object1037/dash/README.md

# Dash

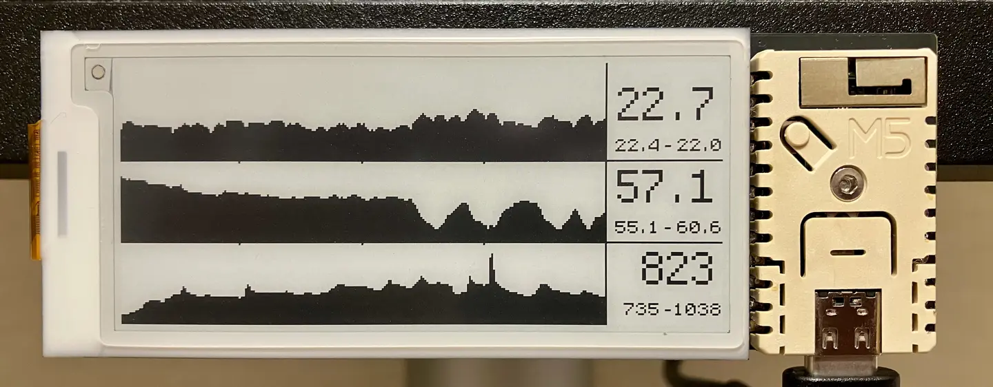
[picture p1: dash.webp]
Dash image


Environment monitor (Temperature, Relative humidity, CO2) with e-paper display.

Inspired by [pico-env-mon](https://github.com/shapoco/pico-env-mon).
