object1037/dash/hardware/dash.pdf

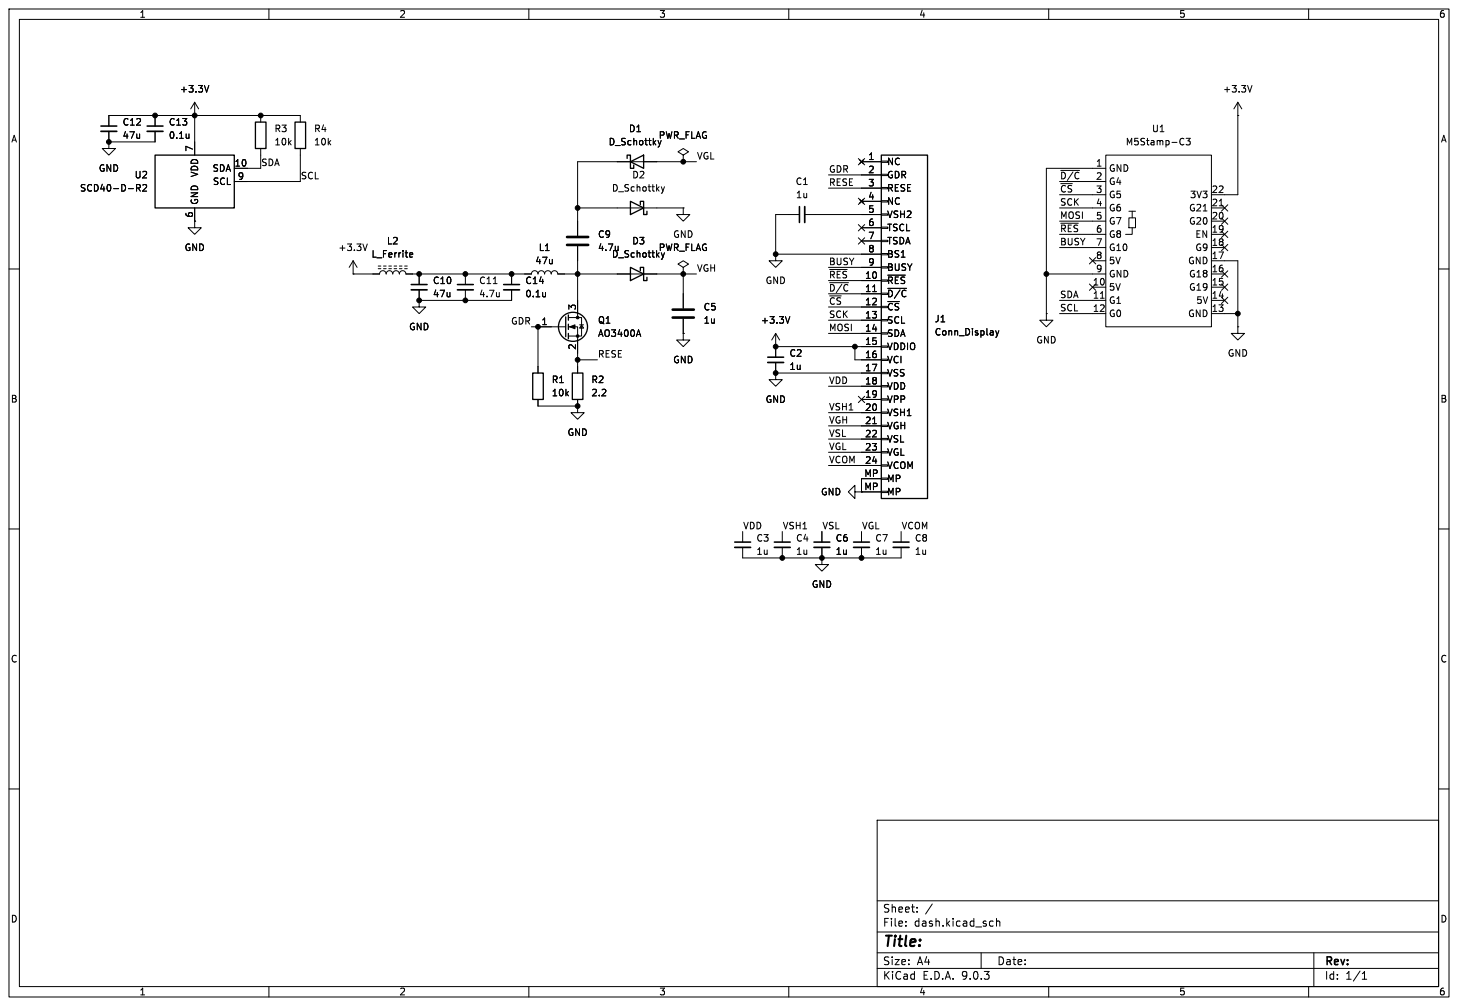
[picture p2: page 1]

6 SDA 10 SCL U2 9 SCD40-D-R2 NC 1 GDR 2 RESE 3 NC 4 VSH2 5 TSCL 6 TSDA 7 BS1 8 BUSY 9 ~{RES} 10 ~{D/C} 11 ~{CS} 12 SCL 13 SDA 14 VDDIO 15 VCI 16 VSS 17 VDD 18 VPP 19 VSH1 20 VGH 21 VSL 22 VGL 23 VCOM 24 MP MP MP MP

6 SDA 10 SCL 9 GND GND GNDGND

Id: 1/1 Title: File: dash.kicad_sch Sheet: /
