object1037/dash/hardware/dash.kicad_pcb

## KiCad design hardware/dash.kicad_pcb (2025-08-30)

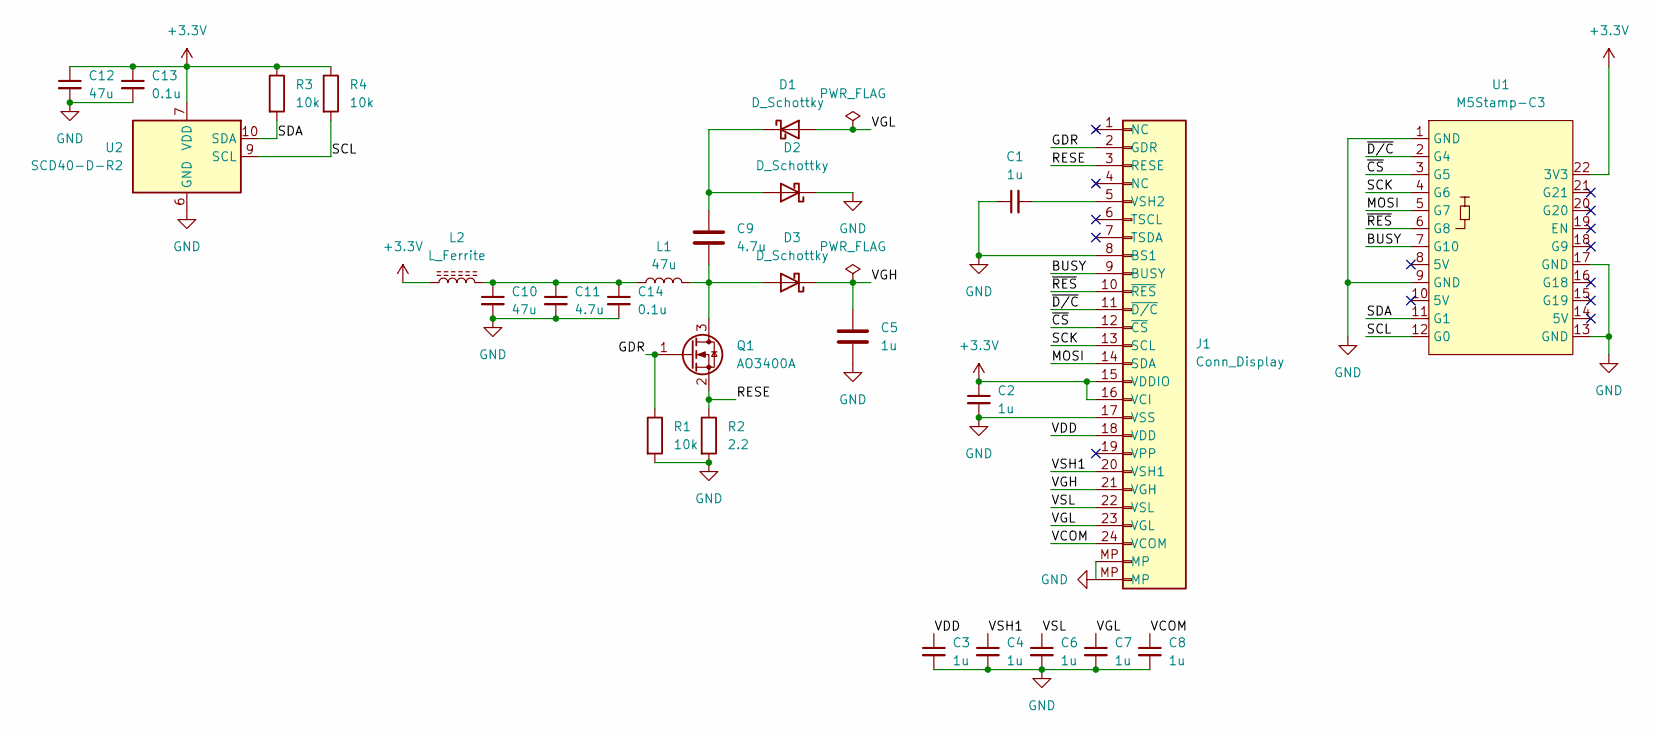
[picture p3: schematic dash.kicad_sch]

Parts:
C1, C2, C3, C4, C5, C6, C7, C8: 1u; C_0603_1608Metric_Pad1.08x0.95mm_HandSolder
C9, C11: 4.7u; C_0805_2012Metric_Pad1.18x1.45mm_HandSolder
C10, C12: 47u; C_0805_2012Metric_Pad1.18x1.45mm_HandSolder
C13, C14: 0.1u; C_0603_1608Metric_Pad1.08x0.95mm_HandSolder
D1, D2, D3: D_Schottky; D_SMA
J1: Conn_Display; Jushuo_AFC07-S24FCA-00_1x24-1MP_P0.50_Horizontal
L1: 47u; L_10.4x10.4_H4.8
L2: L_Ferrite; L_0603_1608Metric_Pad1.05x0.95mm_HandSolder
Q1: AO3400A; SOT-23_Handsoldering
R1, R3, R4: 10k; R_0603_1608Metric_Pad0.98x0.95mm_HandSolder
R2: 2.2; R_0603_1608Metric_Pad0.98x0.95mm_HandSolder
U1: M5Stamp-C3; M5Stamp_C3
U2: SCD40-D-R2; Sensirion_SCD4x-1EP_10.1x10.1mm_P1.25mm_EP4.8x4.8mm

Connections:
+3.3V: C2.1, C12.1, C13.1, J1.15 (VDDIO), J1.16 (VCI), L2.1, R3.1, R4.1, U1.22 (3V3), U2.7 (VDD), U2.19 (VDD)
/BUSY: J1.9 (BUSY), U1.7 (G10)
/GDR: J1.2 (GDR), Q1.1 (G), R1.1
/MOSI: J1.14 (SDA), U1.5 (G7)
/RESE: J1.3 (RESE), Q1.2 (S), R2.1
/SCK: J1.13 (SCL), U1.4 (G6)
/SCL: R4.2, U1.12 (G0), U2.9 (SCL)
/SDA: R3.2, U1.11 (G1), U2.10 (SDA)
/VCOM: C8.1, J1.24 (VCOM)
/VDD: C3.1, J1.18 (VDD)
/VGH: C5.1, D3.1 (K), J1.21 (VGH)
/VGL: C7.1, D1.2 (A), J1.23 (VGL)
/VSH1: C4.1, J1.20 (VSH1)
/VSL: C6.1, J1.22 (VSL)
/~CS: J1.12 (~CS), U1.3 (G5)
/~D/C: J1.11 (~D/C), U1.2 (G4)
/~RES: J1.10 (~RES), U1.6 (G8)
GND: C1.1, C2.2, C3.2, C4.2, C5.2, C6.2, C7.2, C8.2, C10.2, C11.2, C12.2, C13.2, C14.2, D2.1 (K), J1.8 (BS1), J1.17 (VSS), J1.MP, R1.2, R2.2, U1.1 (GND), U1.9 (GND), U1.13 (GND), U1.17 (GND), U2.6 (GND), U2.20 (GND), U2.21 (GND)
unnamed: C10.1, C11.1, C14.1, L1.1, L2.2
unnamed: C9.1, D1.1 (K), D2.2 (A)
unnamed: C9.2, D3.2 (A), L1.2, Q1.3 (D)
unnamed: C1.2, J1.5 (VSH2)

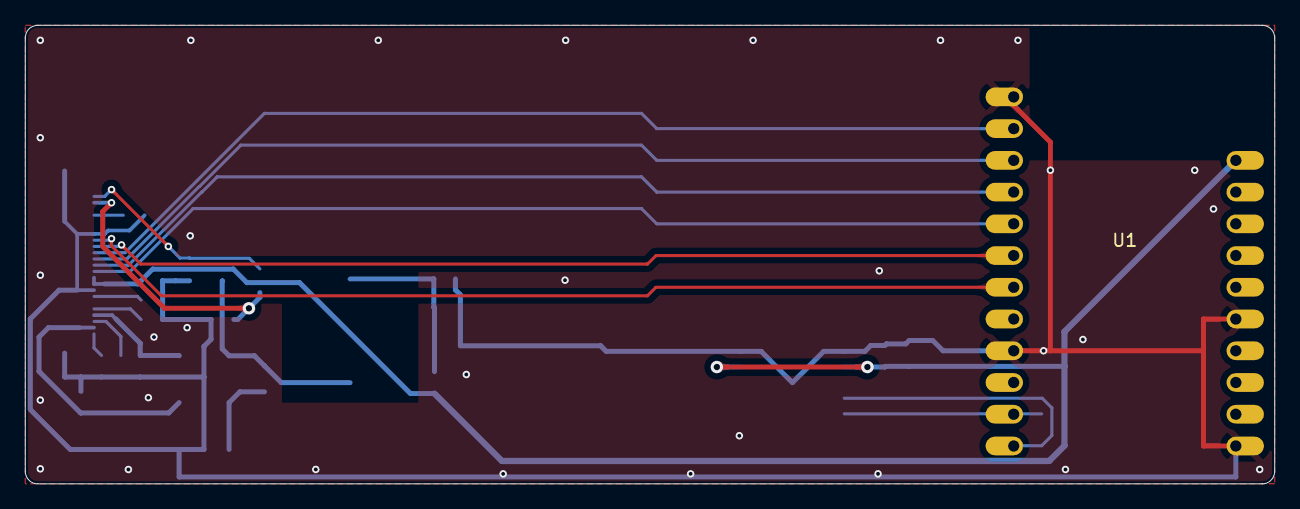
[picture p4: board dash.kicad_pcb from above]

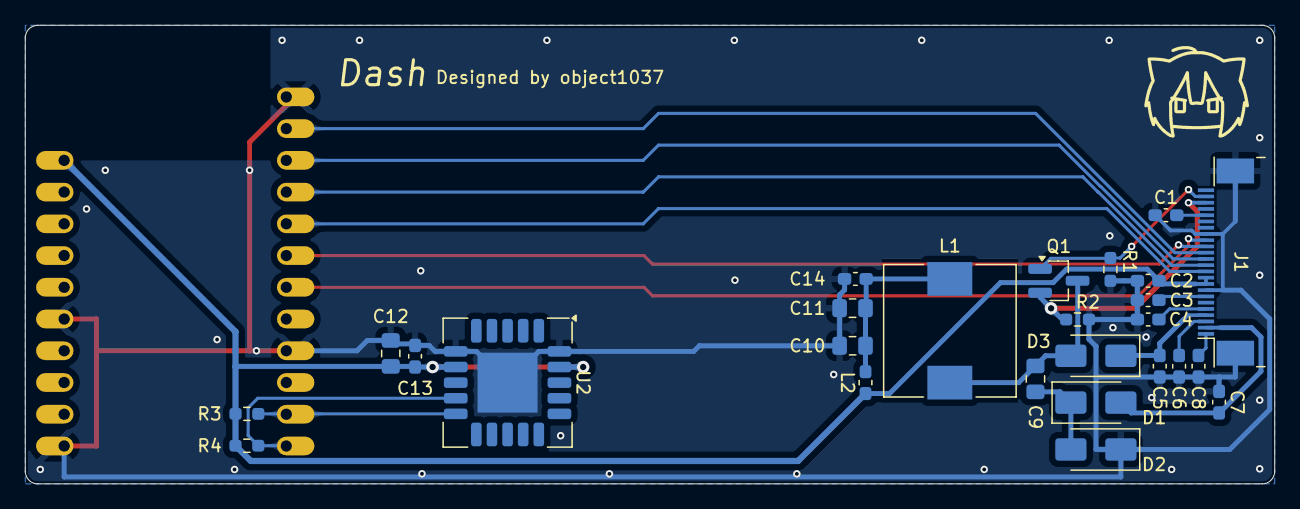
[picture p5: board dash.kicad_pcb from below]

Board: 2 copper layers, 100.0 x 36.7 mm, 27 parts (26 on the bottom side), 22 nets.
