object1037/dash/firmware/main/ui.h

#pragma once

#include "freertos/FreeRTOS.h"
#include "freertos/semphr.h"
#include "freertos/task.h"
#include "esp_lcd_panel_io.h"
#include "scd40.h"

#define EPD_WIDTH 128
#define EPD_HEIGHT 296
#define COLS_BYTE (EPD_WIDTH / 8)
#define BUF_SIZE (EPD_HEIGHT * EPD_WIDTH / 8)
#define TO_IDX(x, y) ((y) * COLS_BYTE + (x))

uint8_t *init_ui_buffer();
void refresh_panel(esp_lcd_panel_handle_t panel_handle, SemaphoreHandle_t panel_refreshing_sem, uint8_t *buf);
void draw_ui(scd40_measurement_t meas_digest[3], scd40_measurement_t meas_history[], int minutes, uint8_t *draw_buf);
