object1037/dash/(commit log)

2025-08-29 update schema
    [dash.kicad_sch]
2025-08-30 schmatic complete
    [dash.kicad_sch]
2025-08-30 finish pcb
    [BOM-dash.csv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]
2025-10-18 plot schematic
2025-11-01 hello world with sensor and display
2025-11-02 display sensor values
2025-11-03 fill graph and bug fix
    [main.c, ui.c]
2025-11-03 fix filter calculation bug
    [main.c]
2025-11-03 use low power measurement for better temp/rh precision
2025-11-04 clamp graph steps to 0--40
